DasReyxr/STM32F-CAR/JP_Carro/PY Fuzzy Logic.pdf

## Sistema de Control Difuso Mamdani para Robot Seguidor de Línea basado en STM32F411

Kevin Adrian Lara Hernandez, Orlando Contreras Reyes, Roberto Lopez Rodriguez¹

Departamento de Ingeniería Electrónica, Universidad Autónoma de Aguascalientes, Aguascalientes, México
464376@edu.uaa.mx,348390@edu.uaa.mx,234512@edu.uaa.mx

Resumen Este trabajo presenta el diseño e implementación de un sistema de control difuso tipo Mamdani para un robot seguidor de línea. El sistema emplea dos sensores reflectivos (ADC de 12 bits) como entradas y genera comandos de velocidad para dos motores de DC mediante modulación por ancho de pulso (PWM). La base de reglas cubre nueve combinaciones de estados sensoriales (negro, gris, blanco), la inferencia se realiza con la operación mínimo-máximo y la defuzzificación mediante el método del centroide integrado numéricamente. El firmware fue desarrollado en C sobre el microcontrolador STM32F411CEU6 usando el HAL de STMicroelectronics, con DMA para la adquisición simultánea de los dos canales del ADC.

Keywords: Lógica difusa · Mamdani · Centroide · Seguidor de línea · STM32F411 · PWM · DMA

### 1. Introducción

Los robots seguidores de línea son una plataforma clásica para evaluar estrategias de control en tiempo real. La lógica difusa resulta especialmente apropiada en este contexto porque los sensores ópticos no producen lecturas binarias perfectas; en las transiciones entre negro y blanco existe una región de incertidumbre que los conjuntos difusos modelan de forma natural [1].
El controlador Mamdani [2] permite expresar el conocimiento del experto como reglas lingüísticas del tipo «Si el sensor izquierdo está en negro y el derecho en blanco, entonces el motor izquierdo va rápido y el derecho va lento», lo que simplifica el ajuste del sistema sin necesidad de un modelo matemático explícito del robot.
En este reporte se describe la arquitectura completa del firmware: funciones de pertenencia, base de reglas, motor de inferencia y defuzzificador analítico/-numérico, así como la configuración de los periféricos del STM32F411 (TIM1, ADC1 con DMA y GPIO).

2 | K. Nombre

### 2. Plataforma de hardware

### 2.1. Microcontrolador

| El sistema se implementa sobre un módulo STM32F411CEU6 (Black-Pill),
que opera a 100 MHz gracias a un cristal externo de 25 MHz con multiplicador PLL (M=12, N=96, P=2). Sus características más relevantes para esta aplicación son: ADC de 12 bits con modo de escaneo y trigger externo, cuatro canales de DMA2, y el temporizador avanzado TIM1 con salidas complementarias y generación de trigger para el ADC.

### 2.2. Sensores

| Se emplean dos sensores reflectivos de infrarrojo conectados a PA0 (sensor
derecho) y PA1 (sensor izquierdo). Las lecturas quedan almacenadas en el arreglo carro.Sensor[] mediante DMA circular, disparado por el canal 3 de TIM1 (modo toggle) a la misma frecuencia que el PWM de los motores (20 kHz), garantizando una muestra por ciclo PWM.

### 2.3. Actuadores

| Dos motores de DC son controlados por un puente H. Las señales de dirección
(AIN1/AIN2 para el motor derecho, BIN1/BIN2 para el izquierdo) se fijan al inicio en modo avance, mientras que la velocidad se regula con los canales CH1 y CH2 de TIM1 en modo PWM. El periodo del contador es de 4 999 cuentas, lo que corresponde a fPWM = 100 MHz/5 000 = 20 kHz.

### 2.4. Fotografía del robot


Figura 1: Prototipo de robot seguidor de línea basado en STM32F411CEU6.

Control Difuso Mamdani – Robot Seguidor de Línea | 3

### 3. Diseño del sistema de lógica difusa

El sistema difuso tiene la siguiente estructura:

Entradas: lectura ADC del sensor izquierdo (left_raw) y del sensor derecho (right_raw).
Salidas: porcentaje de velocidad para el motor izquierdo (MI) y motor derecho (MD), en el rango [0, 100].
Método de inferencia: Mamdani con operadores mínimo (AND) y máximo (OR).
Defuzzificación: centroide (centro de gravedad).

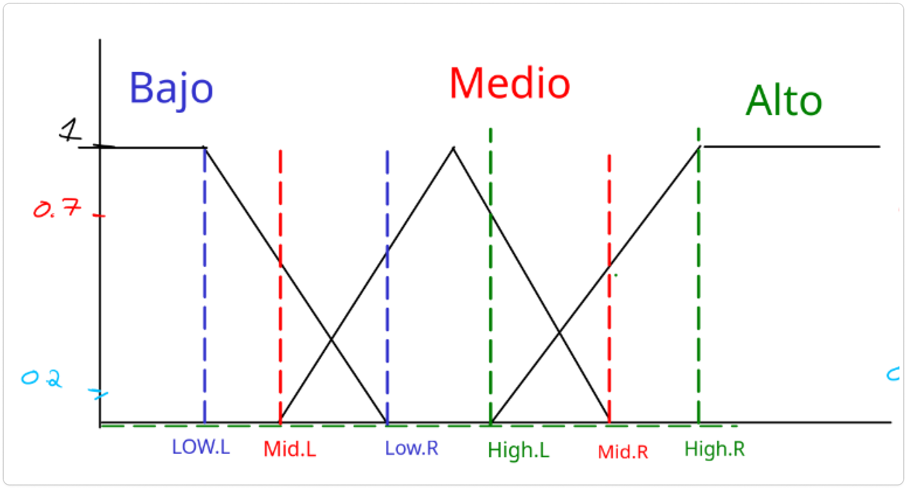
[picture p4: figure]

Figura 2: Funciones de pertenencia del motors

### 3.1. Conjuntos difusos de entrada (sensores)

Cada sensor se clasifica en tres conjuntos lingüísticos definidos sobre el rango de salida del ADC (0–4 095 cuentas):

Cuadro 1: Parámetros de los conjuntos difusos de entrada.

Conjunto | L | C | R Tipo

Blanco (White) 3 500 — 3 600 Trapezoide izq.
Gris (Gray) 3 600 3 760 3 900 Triangular
Negro (Black) 3 900 — 4 020 Trapezoide der.

Las funciones de pertenencia son:

4 | K. Nombre

µWhite(x) =

1 | x ≤ 3500
3600 − x
3600 − 3500 | 3500 < x < 3600
0 | x ≥ 3600

(1)

µGray(x) =

0 | x ≤ 3600
x − 3600
3760 − 3600 | 3600 < x ≤ 3760
3900 − x
3900 − 3760 | 3760 < x < 3900
0 | x ≥ 3900

(2)

µBlack(x) =

0 | x ≤ 3900
x − 3900
4020 − 3900 | 3900 < x < 4020
1 | x ≥ 4020

(3)

3,400
3,500

3,600

3,760

3,900

4,020

4,100

0

0,5

1

Lectura ADC (cuentas)

Grado de pertenencia

µ
Blanco
Gris
Negro

Figura 3: Funciones de pertenencia de los sensores de entrada.

### 3.2. Conjuntos difusos de salida (motores)

Las salidas MI y MD comparten el mismo universo de discurso [0, 100] ( % de velocidad) con tres conjuntos:

Cuadro 2: Parámetros de los conjuntos difusos de salida.

Conjunto L C R Tipo

Bajo (Low) 0 — 50 Trapezoide izq. Medio (Mid) 25 50 75 Triangular Alto (High) 50 — 100 Trapezoide der.

Control Difuso Mamdani – Robot Seguidor de Línea | 5
0 | 25 | 50 | 75 | 100

0

0,5

1

Velocidad ( %)

Grado de pertenencia

µ
Bajo
Medio
Alto

Figura 4: Funciones de pertenencia de las salidas (motores MI y MD).

### 4. Base de reglas Mamdani

La Tabla 3 muestra las nueve reglas que componen la base de conocimiento del controlador. Cada regla tiene la forma:

SI L ∈ AL AND R ∈ AR ⇒ MI ∈ BMI, MD ∈ BMD

donde L y R son las lecturas del sensor izquierdo y derecho respectivamente, A∗ son conjuntos de entrada y B∗ conjuntos de salida. El parámetro peso escala la fuerza de la regla antes de la agregación.

Cuadro 3: Base de reglas Mamdani (L = sensor izq., R = sensor der.).

# Sensor L Sensor R MI (izq.) MD (der.) Peso

1 Blanco | Blanco | Alto | Alto | 1.0
2 | Gris | Blanco | Alto | Medio | 2.0
3 Blanco | Gris | Medio | Alto | 2.0
4 | Negro | Blanco | Alto | Bajo | 2.0
5 Blanco | Negro | Bajo | Alto | 2.0
6 | Gris | Gris | Medio | Medio | 1.0
7 | Negro | Gris | Alto | Bajo | 1.0
8 | Gris | Negro | Bajo | Alto | 1.0
9 | Negro | Negro | Bajo | Alto | 1.0

### 5. Motor de inferencia

### 5.1. Fuzzificación

Para cada sensor se calculan los tres grados de pertenencia mediante las funciones definidas en las ecuaciones (1)–(3). La implementación en FuzzyLogic.c utiliza las funciones genéricas Trapz() y Triang():

6 | K. Nombre
1 | float Trapz ( float x , FuzzyArgs args , uint8_t type )
2 | {
3 | if( type == TRAPZ_LOW ) {
4 | if( x <= args . L ) return 1.0 f ;
5 | if( x < | args . R ) return ( args . R - x ) /( args . R - args .L )
;
6 | return 0.0 f ;
7 | }
8 | if( type == TRAPZ_HIGH ) {
9 | if( x <= args . L ) return 0.0 f ;
10 | if( x < | args . R ) return ( x - args . L) /( args . R - args . L )
;
11 | return 1.0 f ;
12 | }
13 | }

14
15 | float Triang ( float x , FuzzyArgs args ) {
16 | if( x <= args . L ) | return 0.0 f ;
17 | if( x < args . C && x > args . L ) return (x - args .L ) /( args .C -
args . L ) ;
18 | if( x < args . R && x > args . C ) return ( args .R -x ) /( args .R -
args . C ) ;
19 | return 0.0 f ;
20 | }
Listing 1.1: Funciones de pertenencia genéricas (FuzzyLogic.c).

### 5.2. Evaluación de reglas

La función Mamdani_Infer() recorre la base de reglas, calcula la fuerza de disparo de cada regla como αi = wi

·m´ın(µL, µR) y la agrega por motor mediante el operador máximo:

yLOW = m´ax
i

{αi

| consecuente(i) = LOW} | (4)

y análogamente para los conjuntos MEDIO y ALTO.

### 5.3. Defuzzificación por centroide numérico

La función Centroide() implementa la integral discreta:

u

∗ =

X

100

x=0

x · µagg(x)

X

100

x=0

µagg(x)

(5)

donde µagg(x) = m´ax(ˆµLOW, µˆMID, µˆHIGH) con µˆk(x) = m´ın(yk, µk(x)). El paso de integración es ∆x = 0,1, dando 1 001 puntos en el universo de discurso.

Control Difuso Mamdani – Robot Seguidor de Línea | 7
1 | float Centroide ( float y_low , float y_mid , float y_high )
2 | {
3 | float num = 0.0 f , den = 0.0 f;
4 | for( float x = 0.0 f ; x <= 100.0 f ; x += 0.1 f ){
5 | float low | = fminf ( y_low ,
6 | FuzzyMembership (x , Low , | TRAPZ_LOW
) ) ;
7 | float mid | = fminf ( y_mid ,
8 | FuzzyMembership (x , Mid , | TRIANG ) ) ;
9 | float high = fminf ( y_high ,
10 | FuzzyMembership (x , High ,
TRAPZ_HIGH )) ;
11 | float mu | = fmaxf ( low , fmaxf ( mid , high ) ) ;
12 | num += x * mu ;
13 | den += mu ;
14 | }
15 | if( den == 0.0 f ) return 0.0 f ;
16 | return num / den ;
17 | }
Listing 1.2: Defuzzificación por centroide numérico (Centroide.c).

### 6. Cálculo analítico de áreas (módulo Centroide)

Adicionalmente al centroide numérico, el módulo Centroide.c implementa funciones analíticas de área y centroide para cada región de la función de salida agregada. Esto fue diseñado como alternativa de mayor eficiencia computacional.

### 6.1. Inicialización (Centroide_Init)

Durante la inicialización se precomputan las intersecciones entre conjuntos adyacentes:

Y1 =

RLow · CMid − LLow · LMid

(CMid − LMid) + (RLow − LLow)

(6)

Y2 =

RHigh · RMid − LHigh · CMid

(RMid − CMid) + (RHigh − LHigh)

(7)

### 6.2. Regiones de área

Se definen cinco funciones de área: Area_Low, Area_Mid, Area_High, Area_InterLm (intersección Low–Mid) y Area_InterMh (intersección Mid–High). Cada una devuelve una estructura DefuzzArgs con numerador (PAiCi) y denominador
(

PAi) para aplicar el teorema del centroide compuesto:

u

∗ =

P
i Ai
P
- Ci

i Ai

(8)

8 | K. Nombre

### 7. Configuración de periféricos STM32F411

### 7.1. Reloj del sistema

Cuadro 4: Configuración de la PLL del STM32F411.

Parámetro Valor

Fuente | HSE 25 MHz
PLLM | 12
PLLN | 96
PLLP | 2
SYSCLK 100 MHz
HCLK | 100 MHz
APB1 | 50 MHz
APB2 | 100 MHz

### 7.2. TIM1 – PWM y trigger ADC

TIM1 opera en modo up-counting con prescaler 0 y periodo ARR = 4 999, lo que resulta en una frecuencia de f = 100 MHz/5000 = 20 kHz.

CH1 (PA8): PWM modo 1, motor derecho.
CH2 (PA9): PWM modo 1, motor izquierdo.
CH3 (interno): modo toggle, genera TIM1_TRGO para disparar el ADC por hardware (ADC_EXTERNALTRIGCONV_T1_CC3).

El ciclo de trabajo se actualiza en el lazo principal:

1 | __HAL_TIM_SET_COMPARE (& htim1 , TIM_CHANNEL_1 ,
2 | ( uint32_t ) ( cmd . left | * 0.5 f * PWM_PERIOD / 100.0 f ) ) ;
3 | __HAL_TIM_SET_COMPARE (& htim1 , TIM_CHANNEL_2 ,
4 | ( uint32_t ) ( cmd . right * 0.5 f * PWM_PERIOD / 100.0 f) ) ;
Listing 1.3: Actualización de PWM en el lazo principal (main.c).

El factor 0.5 limita el ciclo de trabajo máximo al 50 % del periodo, evitando sobrecalentamiento del puente H en condiciones de velocidad plena.

### 7.3. ADC1 con DMA

El ADC1 opera en modo de escaneo de dos canales (CH0 → sensor derecho, CH1 → sensor izquierdo), con trigger externo ascendente proveniente de TIM1_CH3. El DMA2_Stream0 transfiere automáticamente los resultados al arreglo carro.Sensor[2] con modo circular, garantizando que el lazo principal siempre lea la muestra más reciente sin overhead de CPU.

Control Difuso Mamdani – Robot Seguidor de Línea | 9

### 7.4. GPIO

Las señales de dirección del puente H se configuran como salidas push-pull en el puerto GPIOA:

Cuadro 5: Asignación de pines de dirección.

Pin Señal Función

PA2 AIN1 Dirección motor derecho (1) PA3 AIN2 Dirección motor derecho (2) PA4 BIN1 Dirección motor izquierdo (1) PA5 BIN2 Dirección motor izquierdo (2)

Al inicio, AIN1 y BIN1 se ponen en nivel alto (avance).

### 8. Arquitectura del software

ADC1 + DMA
(Sensor[0], Sensor[1]) Fuzzificación (Black, Gray, White)

Inferencia Mamdani
(Mamdani_Infer)

Defuzzificación centroide
(Centroide)

TIM1 PWM
(cmd.left, cmd.right)

Figura 5: Diagrama de flujo del sistema de control difuso.

La estructura modular del proyecto se compone de cuatro archivos fuente independientes:

FuzzyLogic.c/.h Funciones primitivas de pertenencia (Trapz, Triang), operadores difusos (AND, OR) y funciones de pertenencia específicas para sensores y motores.
Mamdani.c/.h Base de reglas, motor de inferencia (Mamdani_Infer) y función de alto nivel (Mamdani_MotorCommand).
Centroide.c/.h Defuzzificador numérico (Centroide) y funciones analíticas de área (Area_Low, Area_Mid, Area_High, Area_InterLm, Area_InterMh). main.c/.h Configuración HAL, lazo principal y estructura CarroData.

10 K. Nombre

Cuadro 6: Desempeño cualitativo por escenario de prueba.

Escenario | Seguimiento Oscilación
Línea recta | — | —
Curva suave | — | —
Curva cerrada | — | —
Pérdida de línea | — | —

### 9. Discusión

La base de reglas de nueve entradas cubre de forma exhaustiva el espacio de estados sensoriales binario-difuso. Los pesos de 2.0 asignados a las reglas de corrección de rumbo (filas 2–5 de la Tabla 3) aumentan la influencia de esas reglas sobre el motor de agregación sin alterar la estructura Mamdani.
El ciclo de defuzzificación numérica con ∆x = 0,1 implica 1 001 iteraciones por motor, totalizando 2 002 evaluaciones de FuzzyMembership por ciclo de control. A 96 MHz esta carga es asumible, pero las funciones analíticas de Centroide.c podrían reducirla significativamente si el tiempo de cómputo se convierte en un cuello de botella.

### 10. Conclusiones

Se diseñó e implementó exitosamente un controlador difuso tipo Mamdani para un robot seguidor de línea sobre el STM32F411CEU6. El sistema integra adquisición analógica con DMA, generación de PWM sincronizada y una cadena completa de inferencia difusa organizada en módulos independientes y reutilizables.
Como trabajo futuro se propone:
1. Validar las funciones analíticas de centroide y sustituir el método numérico para reducir el tiempo de cómputo.
2. Ajustar los umbrales de los conjuntos difusos de entrada mediante calibración en línea.
3. Agregar una regla de frenado controlado cuando ambos sensores detecten negro por más de N ciclos consecutivos.

Referencias

1. Zadeh, L.A.: Fuzzy sets. Information and Control 8(3), 338–353 (1965). https: //doi.org/10.1016/S0019-9958(65)90241-X
2. Mamdani, E.H., Assilian, S.: An experiment in linguistic synthesis with a fuzzy logic controller. International Journal of Man-Machine Studies 7(1), 1–13 (1975). https://doi.org/10.1016/S0020-7373(75)80002-2

Control Difuso Mamdani – Robot Seguidor de Línea 11

3. Ross, T.J.: Fuzzy Logic with Engineering Applications, 3rd edn. Wiley, Chichester (2010).
4. STMicroelectronics: | STM32F411xC/E | Reference | Manual | (RM0383).
Rev. | 3 | (2023). | https://www.st.com/resource/en/reference_manual/
rm0383-stm32f411xce-advanced-armbased-32bit-mcus-stmicroelectronics. pdf (https://www.st.com/resource/en/reference_manual/rm0383-stm32f411xce-advanced-armbased-32bit-mcus-stmicroelectronics.pdf)
