DasReyxr/STM32F-CAR/HW_PCB/LaMano/readme.md

# Log File
## 6-29-26
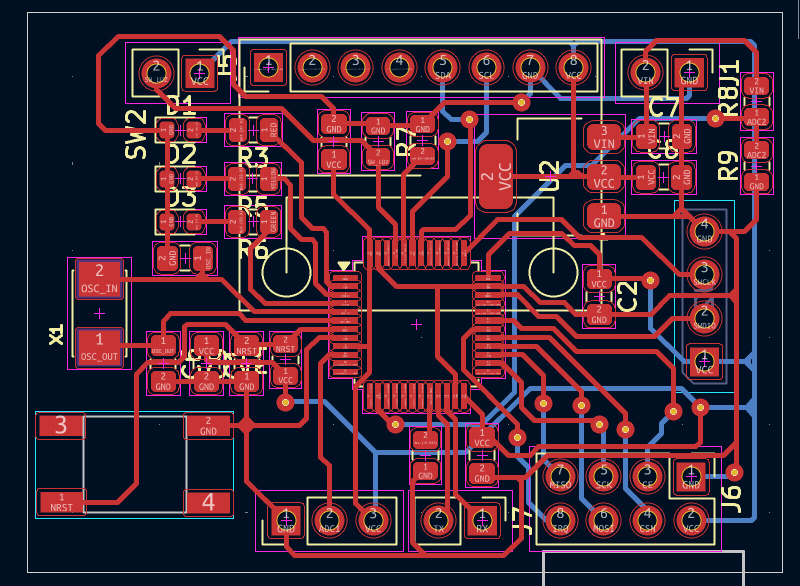
[picture p5: HW_PCB/LaMano/src/readme/image-1.png]

## 6-29-26
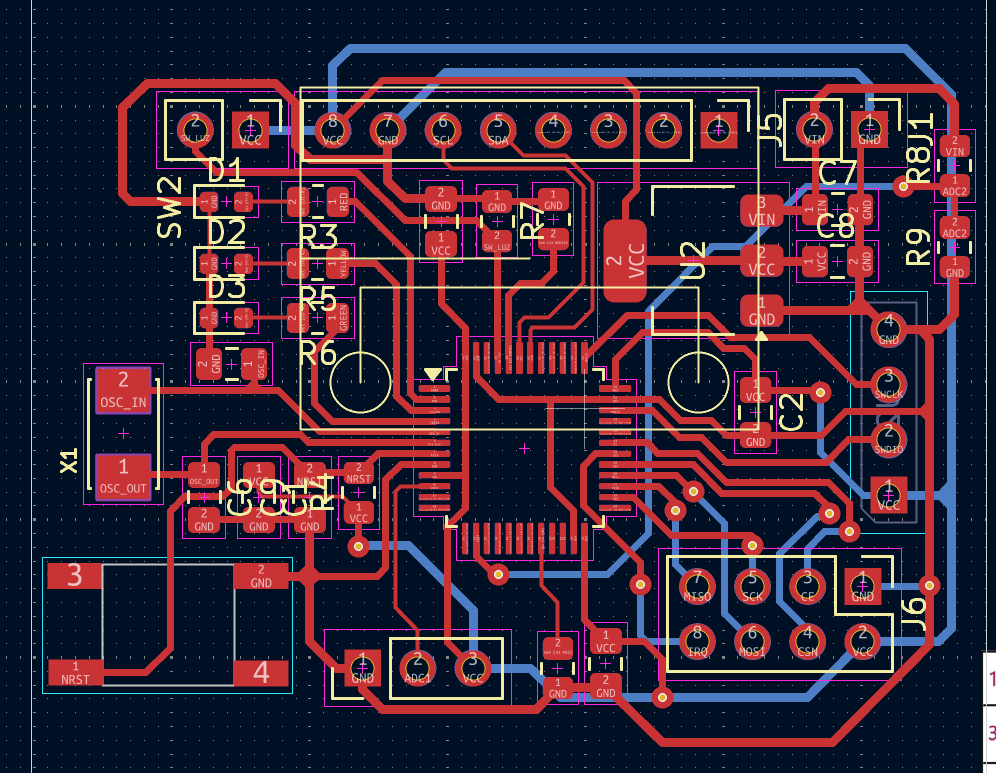
[picture p6: HW_PCB/LaMano/src/readme/image.png]

## 6-29-26
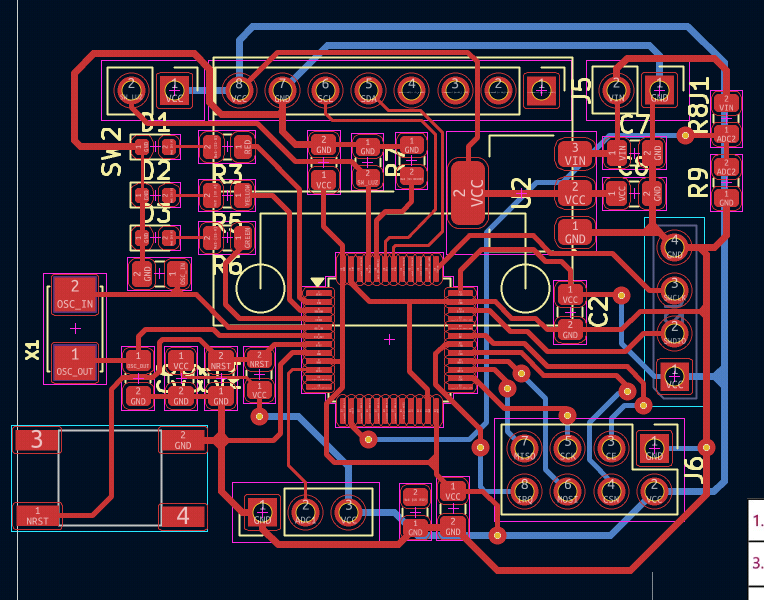
[picture p7: HW_PCB/LaMano/src/readme/6-29-26.png]

## 6-24-26
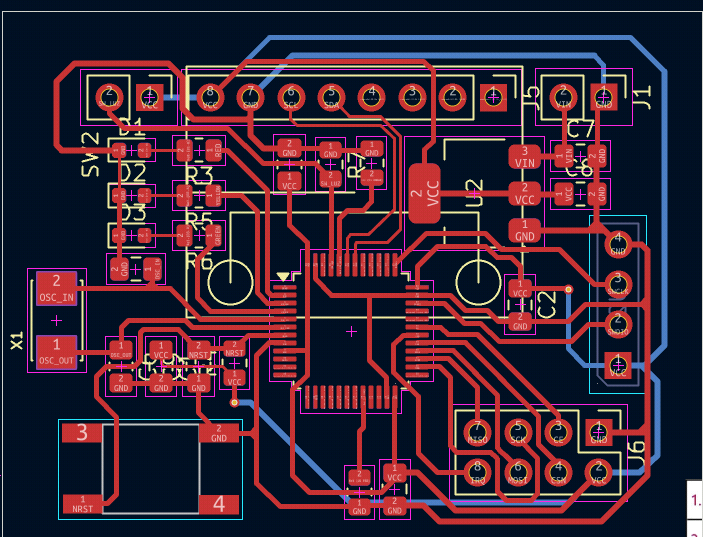
[picture p8: HW_PCB/LaMano/src/readme/6-24-26.png]

## 6-23-26
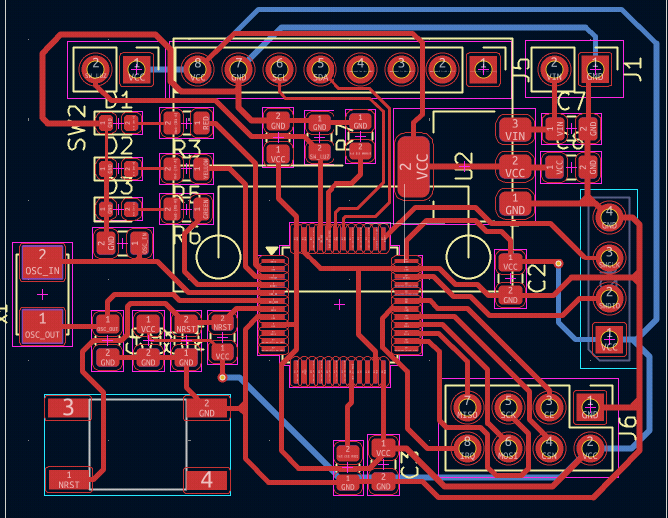
[picture p9: HW_PCB/LaMano/src/readme/6-23-26.png]

# 8-27-26
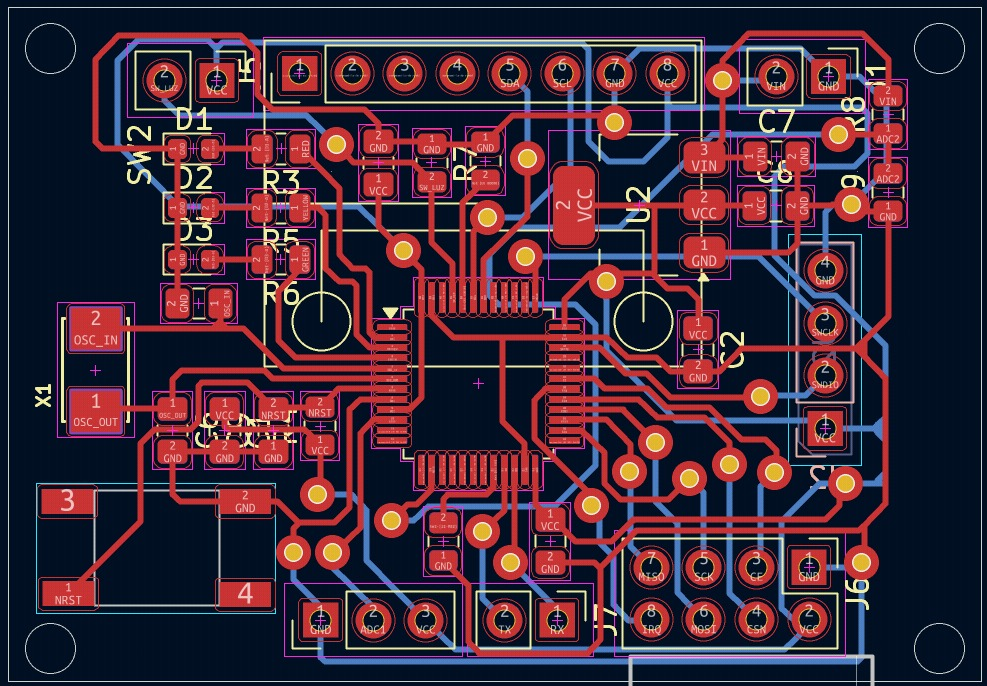
[picture p10: HW_PCB/LaMano/src/readme/image-2.png]
