DasReyxr/STM32F-CAR/doc/FuzzyLogicMath.pdf

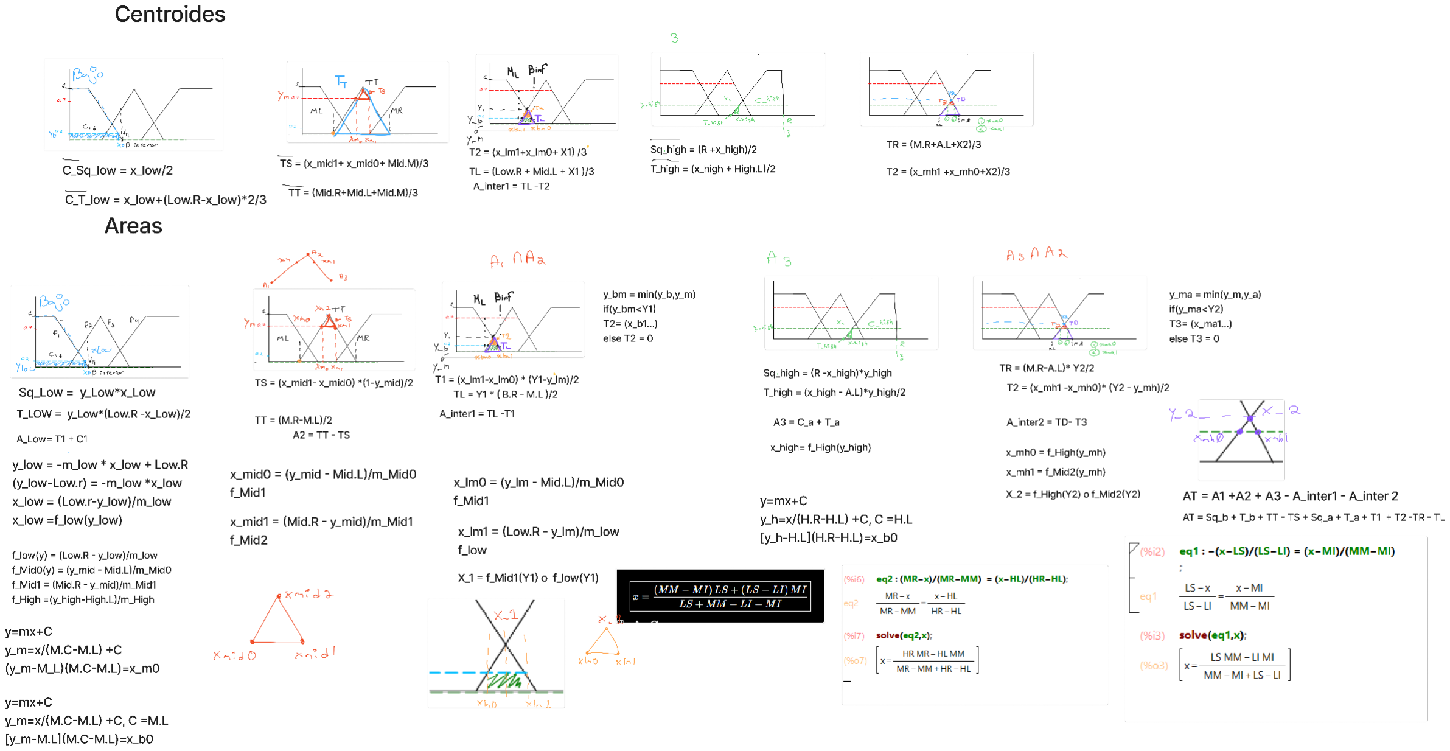
[picture p11: page 1]
