DasReyxr/STM32F-CAR/HW_PCB/Librerias/MPU6050/6050_MPU_r0.step

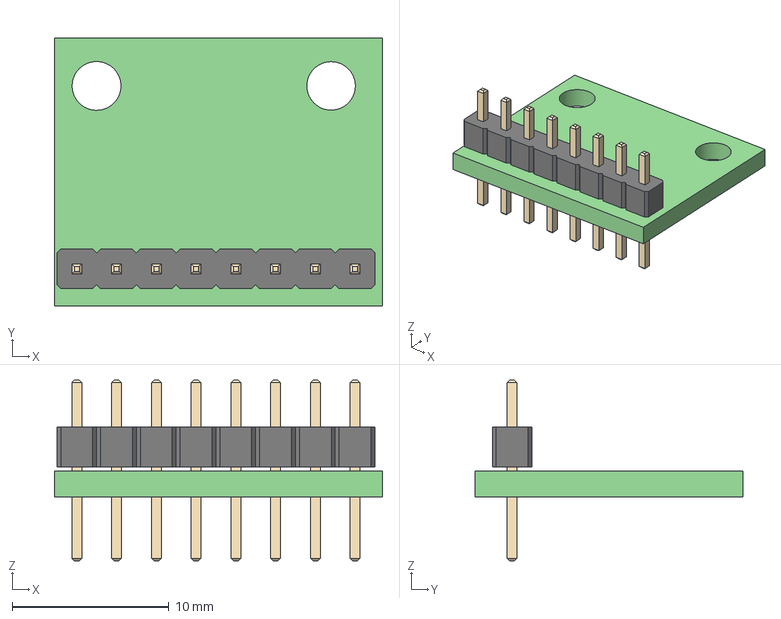
[picture p12: CAD file, 2026-04-01]
HW_PCB/Librerias/MPU6050/6050_MPU_r0.step
21.0 x 17.1 x 11.5 mm
