DasReyxr/STM32F-CAR/HW_PCB/Librerias/TAJB226K016RNJ/TAJB226K016RNJ.step

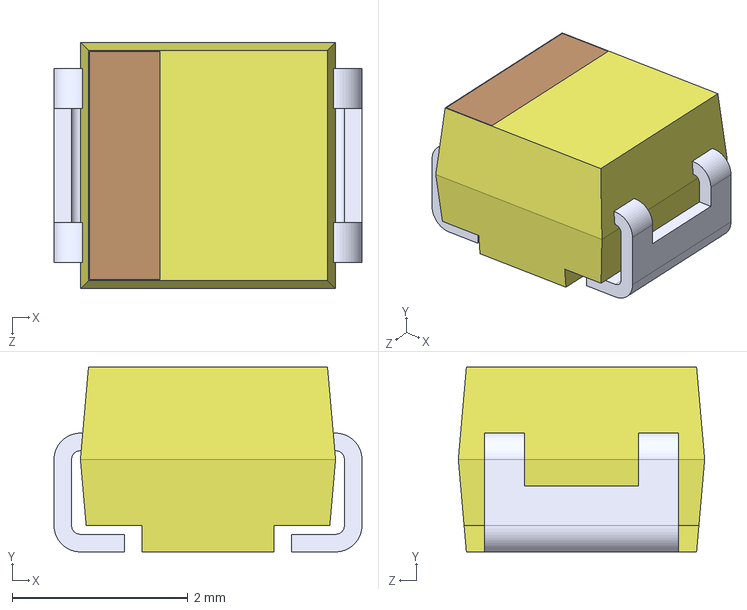
[picture p13: CAD file, 2026-02-24]
HW_PCB/Librerias/TAJB226K016RNJ/TAJB226K016RNJ.step
3.50 x 2.10 x 2.80 mm
