DasReyxr/STM32F-CAR/HW_PCB/Librerias/TB6612FNG/TB6612FNG.step

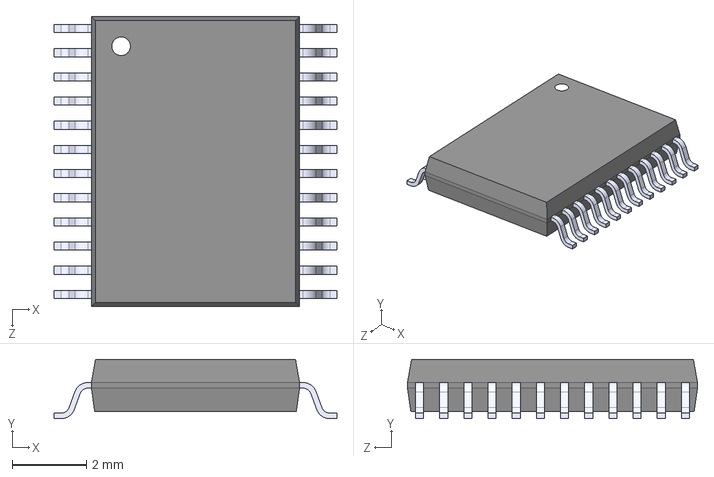
[picture p14: CAD file, 2026-02-23]
HW_PCB/Librerias/TB6612FNG/TB6612FNG.step
7.60 x 1.60 x 7.80 mm
