DasReyxr/STM32F-CAR/(list of files, drawings)

Other design files:
design/KicadDesign/Design/temp-freerouting.dsn
JP_Carro/KicadDesign/Design/freerouting.dsn
