DasReyxr/STM32F-CAR/HW_PCB/LaMano/Blue_pill/Blue_pill.kicad_pcb

## KiCad design HW_PCB/LaMano/Blue_pill/Blue_pill.kicad_pcb (2026-08-27)

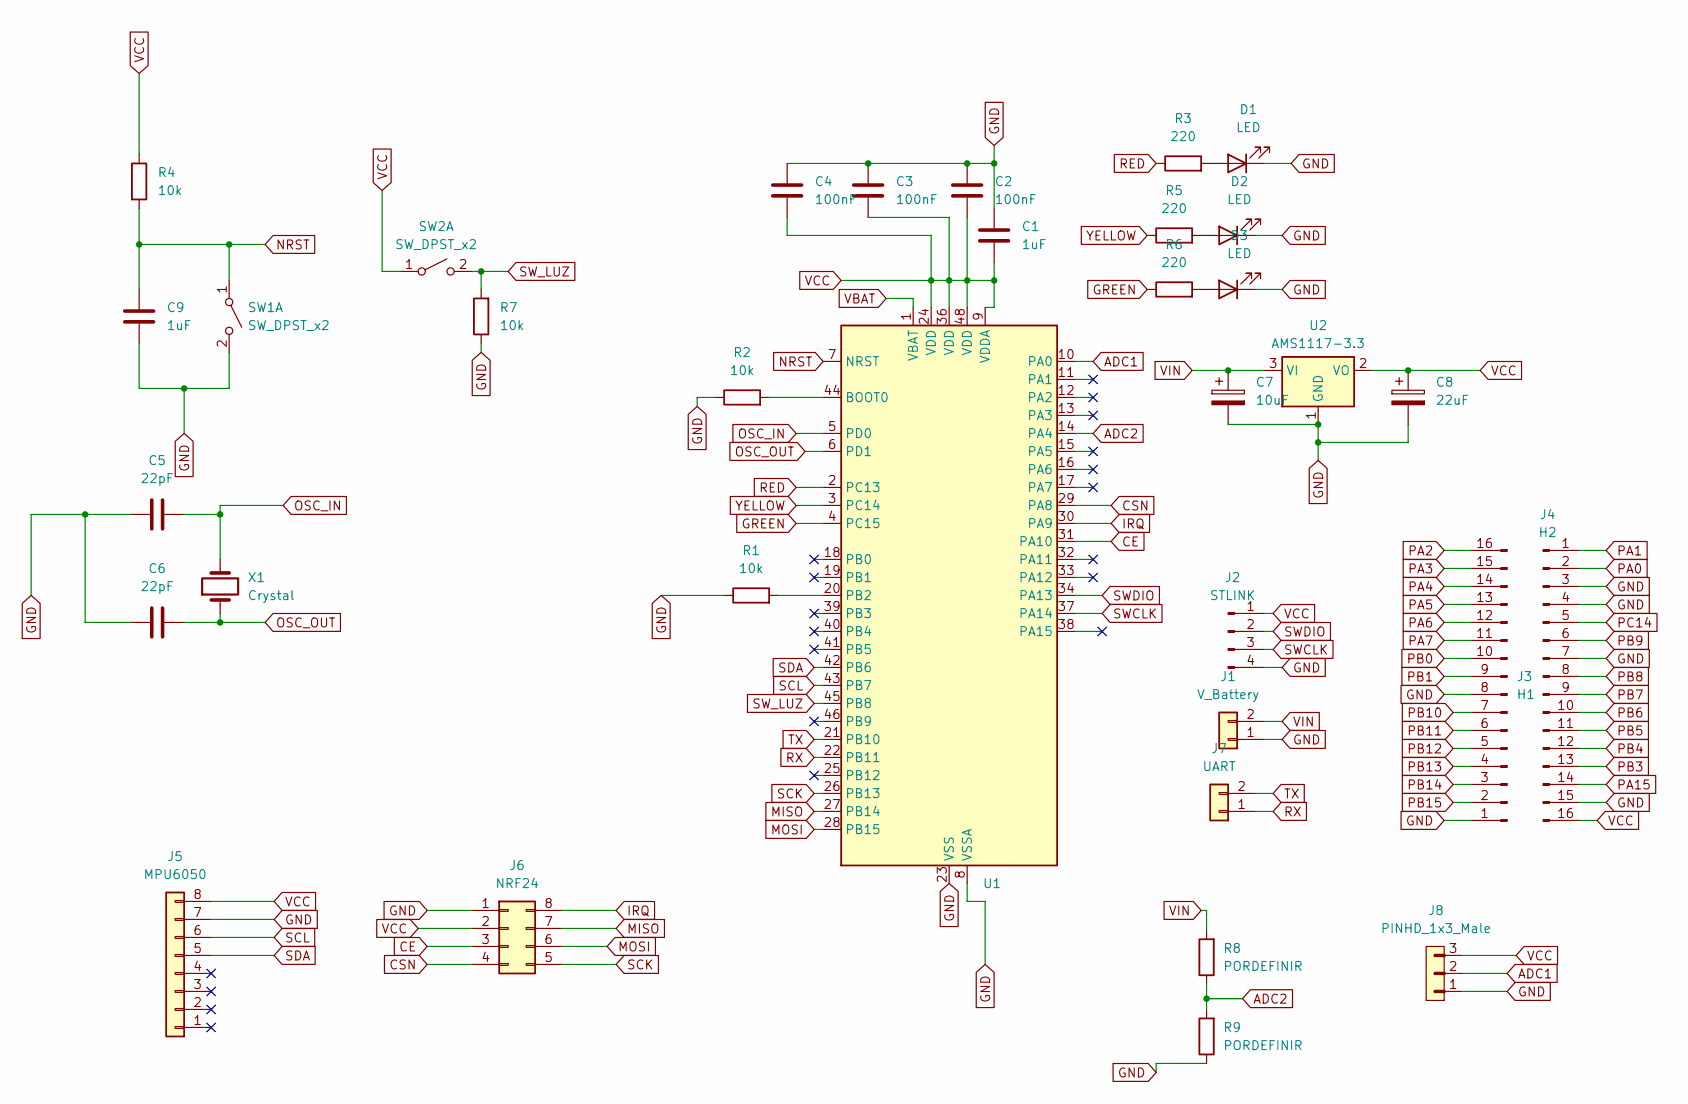
[picture p15: schematic Blue_pill.kicad_sch]

Parts:
C1, C9: 1uF; C_0805_2012Metric_Pad1.18x1.45mm_HandSolder
C2, C3, C4: 100nF; C_0805_2012Metric_Pad1.18x1.45mm_HandSolder
C5, C6: 22pF; C_0805_2012Metric_Pad1.18x1.45mm_HandSolder
C7: 10uF; C_0805_2012Metric_Pad1.18x1.45mm_HandSolder
C8: 22uF; C_0805_2012Metric_Pad1.18x1.45mm_HandSolder
D1, D2, D3: LED; LED_0805_2012Metric
J1: V_Battery; PinHeader_1x02_P2.54mm_Vertical
J2: STLINK; PinHeader_1x04_P2.54mm_Vertical
J3: H1; PinHeader_1x16_P2.54mm_Vertical
J4: H2; PinHeader_1x16_P2.54mm_Vertical
J5: MPU6050; PinHeader_1x08_P2.54mm_Vertical
J6: NRF24; PinHeader_2x04_P2.54mm_Vertical
J7: UART; PinHeader_1x02_P2.54mm_Vertical
J8: PINHD_1x3_Male; PinHeader_1x03_P2.54mm_Vertical
R1, R2, R4, R7: 10k; R_0805_2012Metric
R3, R5, R6: 220; R_0805_2012Metric
R8, R9: PORDEFINIR; R_0805_2012Metric
SW1: SW_DPST_x2; SWESPECIAL
SW2: SW_DPST_x2; PinHeader_1x02_P2.54mm_Vertical
U1: STM32F103C8Tx; LQFP-48_7x7mm_P0.5mm
U2: AMS1117-3.3; SOT-223-3_TabPin2
X1: Crystal; XTAL_NX5032GA-8.000M-STD-CSU-1

Connections:
ADC1: J8.2, U1.10 (PA0)
ADC2: R8.1, R9.2, U1.14 (PA4)
CE: J6.3, U1.31 (PA10)
CSN: J6.4, U1.29 (PA8)
GND: C1.2, C2.2, C3.2, C4.2, C5.2, C6.2, C7.2, C8.2, C9.1, D1.1 (K), D2.1 (K), D3.1 (K), J1.1, J2.4, J3.1, J3.8, J4.3, J4.4, J4.7, J4.15, J5.7, J6.1, J8.1, R1.1, R2.1, R7.1, R9.1, SW1.2 (B), U1.8 (VSSA), U1.23 (VSS), U1.35 (VSS), U1.47 (VSS), U2.1 (GND)
GREEN: R6.1, U1.4 (PC15)
IRQ: J6.8, U1.30 (PA9)
MISO: J6.7, U1.27 (PB14)
MOSI: J6.6, U1.28 (PB15)
NRST: C9.2, R4.2, SW1.1 (A), U1.7 (NRST)
unnamed: D1.2 (A), R3.2
unnamed: D2.2 (A), R5.2
unnamed: D3.2 (A), R6.2
unnamed: R2.2, U1.44 (BOOT0)
unnamed: R1.2, U1.20 (PB2)
OSC_IN: C5.1, U1.5 (PD0), X1.2
OSC_OUT: C6.1, U1.6 (PD1), X1.1
RED: R3.1, U1.2 (PC13)
RX: J7.1, U1.22 (PB11)
SCK: J6.5, U1.26 (PB13)
SCL: J5.6, U1.43 (PB7)
SDA: J5.5, U1.42 (PB6)
SWCLK: J2.3, U1.37 (PA14)
SWDIO: J2.2, U1.34 (PA13)
SW_LUZ: R7.2, SW2.2 (B), U1.45 (PB8)
TX: J7.2, U1.21 (PB10)
VBAT: U1.1 (VBAT)
VCC: C1.1, C2.1, C3.1, C4.1, C8.1, J2.1, J4.16, J5.8, J6.2, J8.3, R4.1, SW2.1 (A), U1.9 (VDDA), U1.24 (VDD), U1.36 (VDD), U1.48 (VDD), U2.2 (VO)
VIN: C7.1, J1.2, R8.2, U2.3 (VI)
YELLOW: R5.1, U1.3 (PC14)

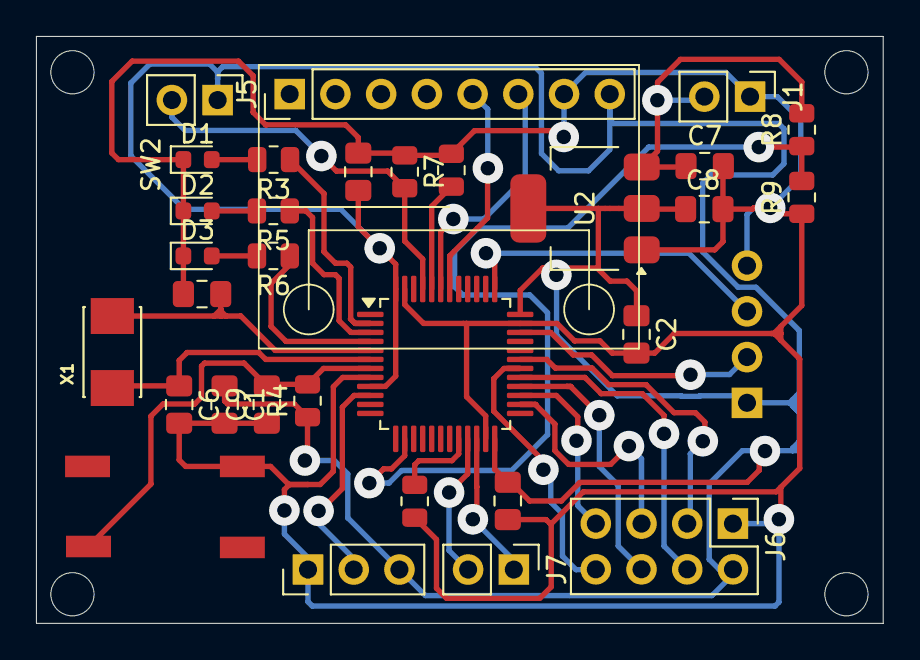
[picture p16: board HW_PCB/LaMano/Blue_pill/Blue_pill.kicad_pcb from above]

Board: 2 copper layers, 47.0 x 32.6 mm, 32 parts (1 on the bottom side), 29 nets.
