DasReyxr/STM32F-CAR/JP_Carro/KicadDesign/Design/Design.kicad_pcb

## KiCad design JP_Carro/KicadDesign/Design/Design.kicad_pcb (2026-06-20)

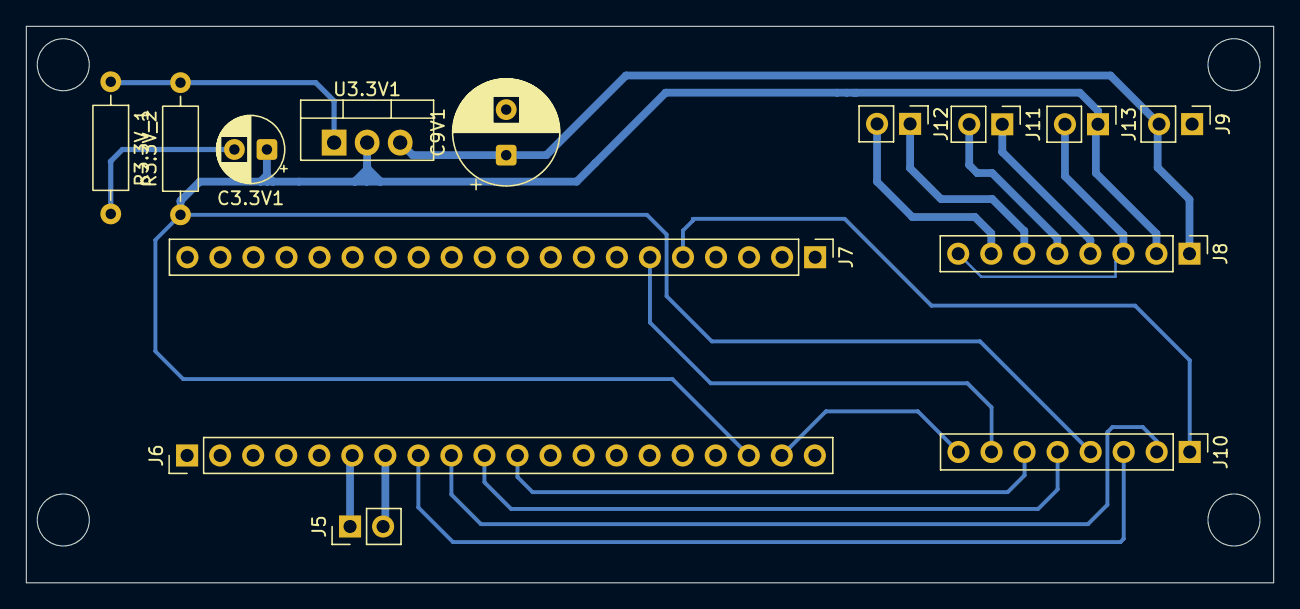
[picture p20: board Design.kicad_pcb from above]

Board: 2 copper layers, 95.9 x 42.8 mm, 14 parts (0 on the bottom side), 16 nets.

Parts:
C3.3V1: 100uF; CP_Radial_D5.0mm_P2.50mm
C9V1: 100uF; CP_Radial_D8.0mm_P3.50mm
J5: SENSOR; PinHeader_1x02_P2.54mm_Vertical
J6, J7: Conn_01x20_Socket; PinHeader_1x20_P2.54mm_Vertical
J8: Puente H; PinHeader_1x08_P2.54mm_Vertical
J9: 9V; PinHeader_1x02_P2.54mm_Vertical
J10: Puente_H2; PinHeader_1x08_P2.54mm_Vertical
J11: A MOTOR; PinHeader_1x02_P2.54mm_Vertical
J12: B MOTOR; PinHeader_1x02_P2.54mm_Vertical
J13: SENSOR_SOURCE; PinHeader_1x02_P2.54mm_Vertical
R3.3V_1: 1500; R_Axial_DIN0207_L6.3mm_D2.5mm_P10.16mm_Horizontal
R3.3V_2: 1K; R_Axial_DIN0207_L6.3mm_D2.5mm_P10.16mm_Horizontal
U3.3V1: LM317_TO-220; TO-220-3_Vertical

Connections:
3.3V: C3.3V1.1, J6.18, J8.2, J10.4, J13.1, R3.3V_2.1, U3.3V1.2 (VO)
9V: C9V1.1, J8.1, J9.2, U3.3V1.3 (VI)
/A01: J8.4, J11.1
/A02: J8.5, J11.2
/B01: J8.6, J12.1
/B02: J8.7, J12.2
A0 ADC_1: J5.1, J6.6
A1 ADC_2: J5.2, J6.7
A2 AIN1: J6.8, J10.3
A3 AIN2: J6.9, J10.2
A4 BIN1: J6.10, J10.5
A5 BIN2: J6.11, J10.6
A8 PWM_IZQ: J7.5, J10.1
A9 PWM_DER: J7.6, J10.7
GND: C3.3V1.2, C9V1.2, J6.19, J8.3, J8.8, J9.1, J10.8, J13.2, R3.3V_1.2
unnamed: R3.3V_1.1, R3.3V_2.2, U3.3V1.1 (ADJ)
