DasReyxr/STM32F-CAR/code/Seguidor_linea/Core/Src/main.c

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
/* Includes ------------------------------------------------------------------*/
#include "main.h"

/* USER CODE BEGIN Includes */
#include "FuzzyLogic.h"
#include "Mamdani.h"
/* USER CODE END Includes */

/* USER CODE BEGIN PTD */
CarroData carro;
MotorCommand_t cmd;
/* USER CODE END PTD */

ADC_HandleTypeDef hadc1;
DMA_HandleTypeDef hdma_adc1;

TIM_HandleTypeDef htim1;

/* USER CODE BEGIN PV */
/*
Frecuencia de motores 20khz
PA8  PWM CH1  Motor derecho
PA9  PWM CH2  Motor izquierdo

PA0  ADC CH0  Sensor derecho
PA1  ADC CH1  Sensor izquierdo

*/
volatile uint8_t adc_ready = 0;
/* USER CODE END PV */

void SystemClock_Config(void);
static void MX_GPIO_Init(void);
static void MX_DMA_Init(void);
static void MX_ADC1_Init(void);
static void MX_TIM1_Init(void);
/**
  * @brief  The application entry point.
  * @retval int
  */
int main(void)
{

  /* MCU Configuration--------------------------------------------------------*/

  /* Reset of all peripherals, Initializes the Flash interface and the Systick. */
  HAL_Init();

  /* Configure the system clock */
  SystemClock_Config();

  /* Initialize all configured peripherals */
  MX_GPIO_Init();
  MX_DMA_Init();
  MX_ADC1_Init();
  MX_TIM1_Init();
  /* USER CODE BEGIN 2 */
  HAL_GPIO_WritePin(GPIOA, AIN1_Pin|BIN1_Pin, GPIO_PIN_SET);
  HAL_GPIO_WritePin(GPIOA, AIN2_Pin|BIN2_Pin, GPIO_PIN_RESET); 
  HAL_TIM_PWM_Start(&htim1, TIM_CHANNEL_1);//PWM para motor derecho
  HAL_TIM_PWM_Start(&htim1, TIM_CHANNEL_2);//PWM para motor izquierdo 
  HAL_TIM_OC_Start(&htim1, TIM_CHANNEL_3);//Trigger para ADC
  Mamdani_Init();
  HAL_ADC_Start_DMA(&hadc1, (uint32_t*)carro.Sensor, 2);
  //HAL_ADC_Start_DMA(&hadc1, (uint32_t*)carro.sensors, 2);
  /* USER CODE END 2 */

  /* Infinite loop */
  /* USER CODE BEGIN WHILE */
  while (1)
  {
    /* USER CODE END WHILE */

    /* USER CODE BEGIN 3 */
      Mamdani_MotorCommand(carro.Sensor[0], carro.Sensor[1], &cmd);
      __HAL_TIM_SET_COMPARE(&htim1, TIM_CHANNEL_1, (uint32_t)(cmd.left*0.5*PWM_PERIOD/100.0f));
      __HAL_TIM_SET_COMPARE(&htim1, TIM_CHANNEL_2, (uint32_t)(cmd.right*0.5*PWM_PERIOD/100.0f));
  }
  /* USER CODE END 3 */
}

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
