DasReyxr/STM32F-CAR/0MainProject/CARRITOBLPRX/CARRITOBLPRX.ioc

Mcu.UserName=STM32F103C8Tx
PA0-WKUP.Signal=S_TIM2_CH1_ETR
PA1.Signal=S_TIM2_CH2
PA10.GPIO_Label=CE
PA10.Signal=GPIO_Output
PA13.Signal=SYS_JTMS-SWDIO
PA14.Signal=SYS_JTCK-SWCLK
PA2.Signal=ADCx_IN2
PA3.GPIO_Label=LeftFront
PA3.Signal=GPIO_Output
PA4.GPIO_Label=LeftBack
PA4.Signal=GPIO_Output
PA5.GPIO_Label=RightFront
PA5.Signal=GPIO_Output
PA6.GPIO_Label=RightBack
PA6.Signal=GPIO_Output
PA8.GPIO_Label=CSN
PA8.Signal=GPIO_Output
PA9.GPIO_Label=IRQ
PA9.Signal=GPXTI9
PB0.GPIO_Label=LED_DIR1
PB0.Signal=GPIO_Output
PB1.GPIO_Label=LED_DIR2
PB1.Signal=GPIO_Output
PB10.Signal=USART3_TX
PB11.Signal=USART3_RX
PB13.Signal=SPI2_SCK
PB14.Signal=SPI2_MISO
PB15.Signal=SPI2_MOSI
PB5.Signal=S_TIM3_CH2
PB6.GPIO_Label=LUZ
PB6.Signal=GPIO_Output
PB7.GPIO_Label=STOP
PB7.Signal=GPIO_Output
PC13-TAMPER-RTC.GPIO_Label=RED
PC13-TAMPER-RTC.Signal=GPIO_Output
PC14-OSC32_IN.GPIO_Label=YELLOW
PC14-OSC32_IN.Signal=GPIO_Output
PC15-OSC32_OUT.GPIO_Label=GREEN
PC15-OSC32_OUT.Signal=GPIO_Output
PD0-OSC_IN.Signal=RCC_OSC_IN
PD1-OSC_OUT.Signal=RCC_OSC_OUT
