DasReyxr/STM32F-CAR/0MainProject/TXRF/Core/Src/main.c

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
/* Includes ------------------------------------------------------------------*/
#include "main.h"

#include "NRF24.h"
#include "NRF24_reg_addresses.h"
#include "mpu6050.h"

#include <stdio.h>
#include <math.h>

/* USER CODE BEGIN Includes */

typedef struct {
    uint8_t cmd;
    uint8_t speed;
    float angle;
} RF_Data;


/* USER CODE END Includes */

/* USER CODE BEGIN PD */
#define PLD_SIZE sizeof(RF_Data)
#define INITIAL_CMD 0x27
/* USER CODE END PD */

ADC_HandleTypeDef hadc1;
ADC_HandleTypeDef hadc2;

I2C_HandleTypeDef hi2c1;

SPI_HandleTypeDef hspi2;

UART_HandleTypeDef huart3;

/* USER CODE BEGIN PV */
RF_Data txData;
uint8_t dataTx[sizeof(RF_Data)];
uint8_t addrTx[5]="juan1";
uint16_t var = 0x00;
uint8_t speed = 50;
uint16_t batery_val;
uint16_t adc_val;
uint32_t adc32;
float ax, ay, az, gx, gy, gz, t;
float ay_ofst;
char buf_lcd[12];

float roll_rad = 0.0f, roll_deg = 0.0f;
float deg_offset =0.0f, pwm_val=0.0f, operation =0.0f;

uint8_t cmd = INITIAL_CMD;
#define PI 3.14159265

/* USER CODE END PV */

void SystemClock_Config(void);
static void MX_GPIO_Init(void);
static void MX_SPI2_Init(void);
static void MX_ADC1_Init(void);
static void MX_I2C1_Init(void);
static void MX_ADC2_Init(void);
static void MX_USART3_UART_Init(void);
/**
  * @brief  The application entry point.
  * @retval int
  */
int main(void)
{

  /* MCU Configuration--------------------------------------------------------*/

  /* Reset of all peripherals, Initializes the Flash interface and the Systick. */
  HAL_Init();

  /* Configure the system clock */
  SystemClock_Config();

  /* Initialize all configured peripherals */
  MX_GPIO_Init();
  MX_SPI2_Init();
  MX_ADC1_Init();
  MX_I2C1_Init();
  MX_ADC2_Init();
  MX_USART3_UART_Init();
  /* USER CODE BEGIN 2 */
  MPU6050_Init();
  csn_high();
  nrf24_init();
  nrf24_tx_pwr(_0dbm );
  nrf24_data_rate(_2mbps);
  nrf24_set_crc(en_crc,_1byte);
  nrf24_set_channel(100);
  nrf24_pipe_pld_size(0,PLD_SIZE);
  nrf24_open_tx_pipe(addrTx);
  //nrf24_open_rx_pipe(0,addrTx);
  nrf24_stop_listen();
  float deg_gx, deg_gy, deg_gz;

  /* USER CODE END 2 */

  /* Infinite loop */
  /* USER CODE BEGIN WHILE */
  while (1)
  {
    /* USER CODE END WHILE */

    /* USER CODE BEGIN 3 */
	  HAL_ADC_Start(&hadc2);
	  HAL_ADC_Start(&hadc1);




	  if(MPU6050_Read_Data() > 0)
		{
			ax = MPU6050_Get_Ax();
			ay = MPU6050_Get_Ay();
			az = MPU6050_Get_Az();
//			gx = MPU6050_Get_Gx();gy = MPU6050_Get_Gy();gz = MPU6050_Get_Gz();t = MPU6050_Get_Temperature();

    /* Angle
      float denominator = sqrt(ax * ax + az * az);
      roll_rad = atan2(ay, denominator); // arctan(ay/ \sqrt[ax^2+az^2] )
      roll_deg = roll_rad * (180.0f / PI);
      deg_offset = roll_deg+90; // avoid handling negative values on pwm
      pwm_val = 340-(deg_offset*(2.0/3.0)); // 340 - deg*120/180
    */
    /*  
    for 45 deg = 220
    for 135 deg = 340
    */
    if (ay < 0.20 && ay > -0.20) ay = 0.0f;
    ay_ofst=ay+1; // offset from 0 to 2
    pwm_val = 340 - (ay_ofst * (120.0 / 2.0)); // map 0-2 to 340-220
/*
      CMD
      4    3  2   1   0
      LED  FW BW  ST  RSV
*/
    if (HAL_GPIO_ReadPin(GPIOB, BOTONLUZ_Pin) == GPIO_PIN_SET)
                        cmd = 0x10 | (cmd & 0x0F); // LED ON
    else
                        cmd = 0x00 | (cmd & 0x0F); // LED OFF
    if (ax <= -0.8)     cmd = 0x01 | (cmd & 0xF0); //Backwards
    else if (ax >= 0.8) cmd = 0x04 | (cmd & 0xF0);// Front
    else                cmd = 0x02 | (cmd & 0xF0); // Stop
    
    HAL_Delay(200);
		}


	  adc32 = HAL_ADCEx_MultiModeGetValue(&hadc1);
	  var = (uint16_t)(adc32 & 0x0000ffff);
	  adc_val=(uint16_t)((adc32 & 0xffff0000)>>16);
    speed = (var * 101)>>12; // /4095 >>12
    txData.cmd = cmd;
    txData.angle = pwm_val;
    txData.speed = speed;

    nrf24_transmit((uint8_t*)&txData, sizeof(txData));
	  
  /*Battery*/
         batery_val = (adc_val*100)>>12;
         if(batery_val<=33){
         HAL_GPIO_WritePin(GPIOC,RED_Pin,GPIO_PIN_SET);
         HAL_GPIO_WritePin(GPIOC,GREEN_Pin,GPIO_PIN_RESET);}
         else if(batery_val>33 && batery_val<=66){
         HAL_GPIO_WritePin(GPIOC,YELLOW_Pin,GPIO_PIN_SET);
         HAL_GPIO_WritePin(GPIOC,RED_Pin,GPIO_PIN_RESET);}
         else {
         HAL_GPIO_WritePin(GPIOC,GREEN_Pin,GPIO_PIN_SET);
         HAL_GPIO_WritePin(GPIOC,YELLOW_Pin,GPIO_PIN_RESET);}

    /*UART*/

         	 char uart_buf[100];
               int len = snprintf(uart_buf, sizeof(uart_buf), "bat=%d cmd=%d speed=%d angle=%.2f\r\n", batery_val, txData.cmd,txData.speed , txData.angle);
               HAL_UART_Transmit(&huart3, (uint8_t*)uart_buf, len, HAL_MAX_DELAY);
               HAL_Delay(100);
    HAL_Delay(15);  
  }
  /* USER CODE END 3 */
}

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
