DasReyxr/STM32F-CAR/0MainProject/CARRITOBLPRX/Core/Inc/conf.h

#ifndef CONF_H
#define CONF_H


#include "stm32f1xx_hal.h"
#include <string.h>
#include <stm32f1xx.h>

//#include <arm_math.h>
#define PI	3.14159265358979



/* Peripherical Functions*/
extern void CAR_Leds(void);
/* Motor Functions */
extern void CAR_Speed(uint16_t);
extern void CAR_Direction(float);
extern void CAR_Leds(void);
extern void CAR_LeftFront(void);
extern void CAR_LeftBack(void);
extern void CAR_RightFront(void);
extern void CAR_RightBack(void);
extern void CAR_Back(void);
extern void CAR_Front(void);

extern void config(void);
extern void confRCC(void);
extern void confGPIO(void);
extern void confTIMER(void);
#endif
