DasReyxr/STM32F-CAR/(commit log)

2025-12-19 Tested NRF24L01 not working, could be the voltage source'
    [CARRITOBLUEPILL Debug.cfg]
2025-12-21 Add tst with STM32
2025-12-28 Working comm between black n blue pill w/ RF Struct
    [CARRITOBLUEPILL Debug.cfg]
2025-12-28 Servo didnt work in the RFCar
2025-12-31 Fixed Servomotor on RF Car, (didnt considered the PLL)
    [CARRITOBLPRX.ioc, MPU6050_Read.ioc, conf.c, main.c, main.h, mpu6050.c, mpu6050.h]
2026-02-02 Working Car and Hand pending HW
    [CARRITOBLPRX.cfg]
2026-02-23 Se añade sistema minimo de hardware
    [Blue_pill.kicad_pcb, Blue_pill.kicad_sch]
2026-02-23 Se añadió Esquemas preliminares del carro
    [TB6612FNG.step, carro_preliminar.kicad_pcb, carro_preliminar.kicad_sch, driver_puenteH.kicad_pcb, driver_puenteH.kicad_sch]
2026-02-24 Añadi nuevo proyecto del puente-H
    [driver_puenteH.kicad_pcb, driver_puenteH.kicad_sch]
2026-02-24 Driver test Finalizado
    [TAJB226K016RNJ.step, driver_puenteH.kicad_pcb, driver_puenteH.kicad_sch]
2026-02-25 Carrito pcb, 25-02-26
    [carro_preliminar.kicad_pcb, carro_preliminar.kicad_sch, driver_puenteH.kicad_pcb]
2026-02-26 Carrito 26-02-26
    [carro_preliminar.kicad_pcb]
2026-02-26 added an advance for the CAR PCB
    [carro_preliminar.kicad_pcb, carro_preliminar.kicad_sch]
2026-02-27 Placa de carro terminada al menos preliminarmente
    [carro_preliminar.kicad_pcb, carro_preliminar.kicad_sch]
2026-02-28 Modified La Mano & Added Xtal Footprint
    [Blue_pill.kicad_pcb, Blue_pill.kicad_sch, freerouting.dsn]
2026-03-01 Actualizacion minima de repo
    [carro_preliminar.kicad_pcb]
2026-03-01 Añadido divisor de tension para bateria, y conectir para luces indicadoras de bateria
    [carro_preliminar.kicad_pcb, carro_preliminar.kicad_sch]
2026-03-01 Cambios en la posicion d elas luces en el codigo
2026-03-12 PCBCAR FULL
    [carro_preliminar.kicad_pcb, carro_preliminar.kicad_sch]
2026-03-12 HAND FULL
    [Blue_pill.kicad_pcb, Blue_pill.kicad_sch, carro_preliminar.kicad_sch]
2026-03-13 Rearranged components
    [Blue_pill.kicad_pcb]
2026-03-13 Added PowerPlane
    [Blue_pill.kicad_pcb]
2026-03-29 Modified Placa Mano
    [Blue_pill.kicad_pcb, Blue_pill.kicad_sch]
2026-04-01 Pending to add MPU6050 Footprint
    [6050_MPU_r0.step, Blue_pill.kicad_pcb]
2026-04-02 Añadidos hoyos placa carro
    [carro_preliminar.kicad_pcb]
2026-04-07 Updated Kicad
    [Blue_pill.kicad_pcb]
2026-04-07 Pending to route voltage tracks
    [Blue_pill.kicad_pcb, temp-freerouting.dsn]
2026-04-07 Small Joshua Changes
    [Blue_pill.kicad_pcb, freerouting.dsn, temp-freerouting.dsn]
2026-04-08 Pending to route voltages, expected to do one side
    [Blue_pill.kicad_pcb, Blue_pill.kicad_sch]
2026-04-08 Correción menor
    [driver_puenteH.kicad_pcb]
2026-05-07 Added bottom layer, pending to aprove
    [Blue_pill.kicad_pcb]
2026-05-16 Increased the vein sizes
    [Blue_pill.kicad_pcb]
2026-06-05 El chingao proyecto de jp
2026-06-05 Fixed Low and High Trapezoidal on FuzzyLogic
    [FuzzyLogic.c]
2026-06-10 Created Schematic
    [Design.kicad_pcb, Design.kicad_sch]
2026-06-10 Placa terminada
    [Design.kicad_pcb, Design.kicad_sch]
2026-06-11 PCB full
    [Design.kicad_pcb]
2026-06-11 Cambio de reglas Mm
2026-06-12 Centroide Arreglado ahora si -- 2
    [Centroide.c]
2026-06-12 Parece que jala
2026-06-13 Added Readme
    [freerouting.dsn, temp-freerouting.dsn]
2026-06-17 Cambiamos orden trapecios y se arreglo
    [FuzzyLogic.c, Mamdani.c, main.c]
2026-06-20 Readme 1
    [Design.kicad_pcb]
2026-06-20 Modify prototype image in readme.md
    Updated image source for the prototype and added a placeholder image.
2026-06-23 Kicad 9.0->10.0
    [Blue_pill.kicad_pcb]
2026-06-23 DRC 0 Errors (Board cleareance errors, Fix: Increased Board size) Fixed mismatch size on 2 gnd tracks
    [Blue_pill.kicad_pcb]
2026-06-29 6-29 Added Potentiometer Added Voltage divider for Battery Sensor Changed Layer tracks of NRF24
    [Blue_pill.kicad_pcb, Blue_pill.kicad_sch]
2026-06-29 6-29 DRC Check Connect Resistor on PB2
    [Blue_pill.kicad_pcb]
2026-06-29 6-29 Fixed MPU orientation Added Vias
    [Blue_pill.kicad_pcb, Blue_pill.kicad_sch]
2026-07-28 Corregido uncexion en gnd del driver
    [carro_preliminar.kicad_pcb]
2026-08-27 fix: ConnectLaMano Veins
    [Blue_pill.kicad_pcb]
