DasReyxr/STM32F-CAR/(notices)

Notices in the files:
code/Seguidor_linea/Core/Src/main.c:
Copyright (c) 2026 STMicroelectronics.
All rights reserved.
This software is licensed under terms that can be found in the LICENSE file
0MainProject/CARRITOBLPRX/Core/Inc/main.h:
Copyright (c) 2025 STMicroelectronics.
